mahoep/ME-382-code/Final Report/images/image3.JPG

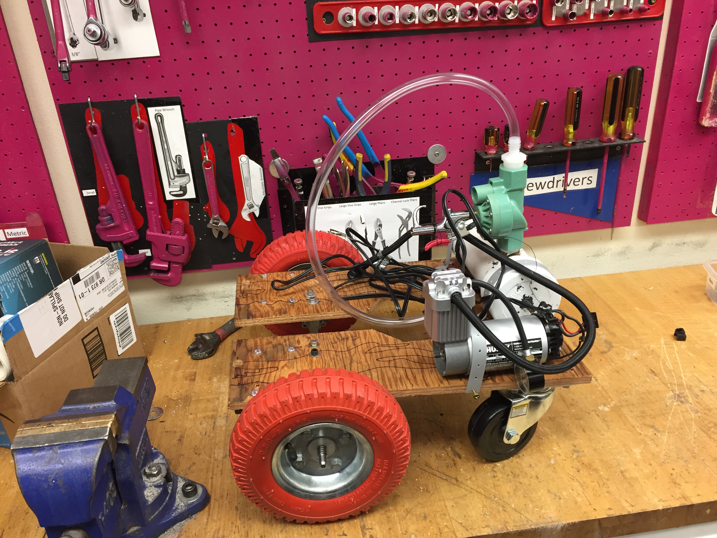
Final Report/images/image3.JPG
